Ch-Fsk/iot-home/下位机/硬件/器件清单.xlsx

器件 | 数量 | 单价 | 合计
1、0805电阻 | 9x2 | 0 | 0
2、0805电容 | 4x2 | 0 | 0
3、直插电容 | 1x2 | 0 | 0
4、蜂鸣器 | 1x2 | 0.8 | 1.6
5、OLED | 1x2 | 21.3 | 42.6
6、HDC1080 | 1x2 | 11.5 | 23
7、ESP-01 wifi | 1x2 | 7.95 | 16
8、Fan风扇 | 1x1 | 11.4+8（运费） | 19.4
9、TEMT6000光强 | 1x2 | 4 | 8
10、Mq2 | 1x1 | 4.6 | 4.6
10、Mq135 | 1X1 | 5.5 | 5.5
11、ss8050 | 2X4 | 0 | 0
12、铜柱 | 4X2X2 | 0.15 | 2.4
13、拨码开关 | 1X2 | 0.3 | 0.6
14、Stm32f103核心板 | 1X2 | 11 | 22
15、PCB打板 | 1X5 | 25+12（邮费） | 37
合计 | - | - | 182.7
