Ch-Fsk/iot-home/(list of files, drawings)

Other design files:
下位机/室内温度检测相关资料/室内空气净化监测原理图和PCB源文件/室内空气净化监测原理图和PCB源文件/430/室内空气监测MSP430.SchDoc
下位机/室内温度检测相关资料/室内空气净化监测原理图和PCB源文件/室内空气净化监测原理图和PCB源文件/STM32/室内空气监测STM32.SchDoc
下位机/硬件/室内环境检测系统/室内环境检测系统.PrjPcb
下位机/硬件/室内环境检测系统/室内环境检测系统.SchDoc
