Ch-Fsk/iot-home/下位机/程序/iotHome/User/hdc1080.c

#include "hdc1080.h"
#include "mi2c.h"
#include "delay.h"
#include "stdio.h"
#include "math.h"
#include "oled.h"
/*********************************************************************************
  * @ 函数名  ： HDC1080_Init
  * @ 功能说明： 初始化HDC1080
  * @ 参数    ： 无
  * @ 返回值  ： 无
  ********************************************************************************/
char hdc_buf[32];

void HDC1080_Init(void)
{
	uint8_t temp[2];
	unsigned int manufac_id,dev_id,Config_Reg ;
	
	IIC_Init();   //IIC初始化
	
	HDC1080_ReadReg(Manufacturer_ID,temp,2);
	manufac_id=(unsigned int)(temp[0]<<8);
	manufac_id+=temp[1];
	sprintf(hdc_buf,"MID = 0x%x\r\n",manufac_id);   /*打印制造商ID */
	OLED_ShowStr(0,0,hdc_buf,1);
	
	HDC1080_ReadReg(Device_ID,temp,2);
	dev_id=(unsigned int)(temp[0]<<8);
	dev_id+=temp[1];
	sprintf(hdc_buf,"Device_ID = 0x%x ",dev_id);   /*打印设备ID*/
	OLED_ShowStr(0,1,hdc_buf,1);
	if((manufac_id != Manufacturer_ID_value)||(dev_id != Device_ID_value))
	{
		sprintf(hdc_buf,"!!!ERROR,Please Check!!!");   /*打印设备连接成功*/
	}
	else 
	{
		sprintf(hdc_buf,"Online!!!");
	}
	OLED_ShowStr(0,2,hdc_buf,1);
	
	Config_Reg=Config_heateroff;   //关闭Heater,同时采集温度和湿度(温度在前),温度分辨率为14位,湿度分辨率为14位
	sprintf(hdc_buf,"config = 0x%x",Config_Reg);
	OLED_ShowStr(0,3,hdc_buf,1);
	HDC1080_WriteReg(Configuration,Config_Reg);  
	
	HDC1080_ReadReg(Configuration,temp,2);
	Config_Reg=(unsigned int)(temp[0]<<8);
	Config_Reg+=temp[1];
	if(Config_Reg == Config_heateroff)   /*检查是否写入成功*/
	{
			sprintf(hdc_buf,"Config success.");   
	}
	else 
	{
			sprintf(hdc_buf,"Configu reg failed.");   
	}
	OLED_ShowStr(0,4,hdc_buf,1);
	
}

/*********************************************************************************
  * @ 函数名  ： HDC1080_WriteReg
  * @ 功能说明： 写数据到寄存器内
  * @ 参数    ： 
	*              WriteAddr:内部寄存器地址
	*							 Data:将要写入的数据
  * @ 返回值  ： 无
  ********************************************************************************/
void HDC1080_WriteReg(u8 WriteAddr,unsigned int Data)
{
	unsigned char data[2];
	data[0] = (uint8_t)((Data& 0xFF00) >> 8);
	data[1] = (uint8_t)(Data & 0x00FF);
	IIC_Start();   //起始信号
	IIC_Send_Byte(HDC1080_I2C_ADDR);   //发送HDC1080设备地址+写信号
	IIC_Wait_Ack();
	IIC_Send_Byte(WriteAddr);   //内部寄存器地址
	IIC_Wait_Ack();
	IIC_Send_Byte(data[0]);   //写入内部寄存器数据
	IIC_Wait_Ack();
	IIC_Send_Byte(data[1]);   //写入内部寄存器数据
	IIC_Wait_Ack();
	IIC_Stop();   //停止信号
	
}

/*********************************************************************************
  * @ 函数名  ： HDC1080_ReadReg
  * @ 功能说明： 读取寄存器内的数据
  * @ 参数    ： 
	*              ReadAddr:内部寄存器地址
  *              pBuffer:数据数组首地址
	*              length:要读出数据的个数
  * @ 返回值  ： 无
  ********************************************************************************/
u8 HDC1080_ReadReg(u8 ReadAddr,u8 *pBuffer,u16 length)
{
		  	    																 
  IIC_Start();   //起始信号
	IIC_Send_Byte(HDC1080_I2C_ADDR);   //发送HDC1080设备地址+写信号
	IIC_Wait_Ack();  
	IIC_Send_Byte(ReadAddr);   //内部寄存器地址
	IIC_Wait_Ack();
	IIC_Start();   //起始信号
	IIC_Send_Byte(HDC1080_I2C_ADDR+1);   //发送HDC1080设备地址+读信号
	IIC_Wait_Ack(); 
	while(length)
	{
		*pBuffer++=IIC_Read_Byte(1);   //读出寄存器数据
		length--;
	}
	IIC_NAck();   //发送nACK
  IIC_Stop();   //停止信号	    
	return 0;
	
}

/*********************************************************************************
  * @ 函数名  ： Read_Temp_Humi_Reg
  * @ 功能说明： 读取温度和湿度寄存器数值
  * @ 参数    ： 
	*              data:温度和湿度寄存器数值
  * @ 返回值  ： 无
  ********************************************************************************/
void Read_Temp_Humi_Reg(u8 *data)
{
	data[0]=0;
	data[1]=0;
	data[2]=0;
	data[3]=0;
	IIC_Start();   //起始信号
	IIC_Send_Byte(HDC1080_I2C_ADDR);   //发送HDC1080设备地址+写信号
	IIC_Wait_Ack();  
	IIC_Send_Byte(Temperature);   //触发测量
	IIC_Wait_Ack();
	DelayMs(20);   /* Temp转换时间 + Humi转换时间 = 20ms */
	IIC_Start();   //起始信号
	IIC_Send_Byte(HDC1080_I2C_ADDR+1);   //发送HDC1080设备地址+读信号
	IIC_Wait_Ack(); 
	data[0]=IIC_Read_Byte(1);   /* 读取温度寄存器数值 */
	data[1]=IIC_Read_Byte(1);
	data[2]=IIC_Read_Byte(1);   /* 读取湿度寄存器数值 */
	data[3]=IIC_Read_Byte(1);
	IIC_Stop();   //停止信号  
	
}

/*********************************************************************************
  * @ 函数名  ： Convert_HDC1080_TempHumidity
  * @ 功能说明： 转化温度和湿度
  * @ 参数    ： 
	*              data:温度和湿度寄存器数值
  * @ 返回值  ： 无
  ********************************************************************************/
void Convert_HDC1080_TempHumidity(float *temp,float *humi)
{
		u8 data[4];
    /* 采集温湿度 */
    Read_Temp_Humi_Reg(data);      
    /* 温度转换 */
    *temp=(float)(data[0]<<8|data[1]);  
    *temp=(*temp/pow(2,16))*165-40;
    /* 湿度转换 */
    *humi=0;  
    *humi=(float)(data[2]<<8|data[3]);
    *humi=(*humi/pow(2,16))*100;
	
}
