Ch-Fsk/iot-home/下位机/程序/iotHome/User/usart.c

#include "sys.h"
#include "usart.h"	
#include "led.h"
#include "delay.h"
#include "alert.h"
#include <stdlib.h>

//////////////////////////////////////////////////////////////////
//加入以下代码,支持printf函数,而不需要选择use MicroLIB	  
#if 1
#pragma import(__use_no_semihosting)             
//标准库需要的支持函数                 
struct __FILE 
{ 
	int handle; 

}; 

FILE __stdout;       
//定义_sys_exit()以避免使用半主机模式    
_sys_exit(int x) 
{ 
	x = x; 
} 
//重定义fputc函数 
int fputc(int ch, FILE *f)
{      
	while((USART1->SR&0X40)==0);//循环发送,直到发送完毕   
    USART1->DR = (u8) ch;      
	return ch;
}
#endif 

/*使用microLib的方法*/
 /* 
int fputc(int ch, FILE *f)
{
	USART_SendData(USART1, (uint8_t) ch);

	while (USART_GetFlagStatus(USART1, USART_FLAG_TC) == RESET) {}	
   
    return ch;
}
int GetKey (void)  { 

    while (!(USART1->SR & USART_FLAG_RXNE));

    return ((int)(USART1->DR & 0x1FF));
}
*/
 

//串口1中断服务程序
//注意,读取USARTx->SR能避免莫名其妙的错误   	
u8 USART_RX_BUF[USART_REC_LEN];     //接收缓冲,最大USART_REC_LEN个字节.
u16 USART_RX_STA=0;       //接收状态标记	  
  
void USART1_Init(u32 baudRate){
  //GPIO端口设置
  GPIO_InitTypeDef GPIO_InitStructure;
	USART_InitTypeDef USART_InitStructure;
	NVIC_InitTypeDef NVIC_InitStructure;
		
	//使能USART1，GPIOA时钟	 
	RCC_APB2PeriphClockCmd(RCC_APB2Periph_USART1|RCC_APB2Periph_GPIOA, ENABLE);
  
	//USART1_TX   GPIOA.9
  GPIO_InitStructure.GPIO_Pin = GPIO_Pin_9; //PA.9
  GPIO_InitStructure.GPIO_Speed = GPIO_Speed_50MHz;
  GPIO_InitStructure.GPIO_Mode = GPIO_Mode_AF_PP;	//复用推挽输出
  GPIO_Init(GPIOA, &GPIO_InitStructure);//初始化GPIOA.9
   
  //USART1_RX	  GPIOA.10初始化
  GPIO_InitStructure.GPIO_Pin = GPIO_Pin_10;//PA10
  GPIO_InitStructure.GPIO_Mode = GPIO_Mode_IN_FLOATING;//浮空输入
  GPIO_Init(GPIOA, &GPIO_InitStructure);//初始化GPIOA.10  

  //Usart1 NVIC 配置
  NVIC_InitStructure.NVIC_IRQChannel = USART1_IRQn;
	NVIC_InitStructure.NVIC_IRQChannelPreemptionPriority=3 ;//抢占优先级3
	NVIC_InitStructure.NVIC_IRQChannelSubPriority = 3;		//子优先级3
	NVIC_InitStructure.NVIC_IRQChannelCmd = ENABLE;			//IRQ通道使能
	NVIC_Init(&NVIC_InitStructure);	//根据指定的参数初始化VIC寄存器
  
   //USART 初始化设置

	USART_InitStructure.USART_BaudRate = baudRate;//串口波特率
	USART_InitStructure.USART_WordLength = USART_WordLength_8b;//字长为8位数据格式
	USART_InitStructure.USART_StopBits = USART_StopBits_1;//一个停止位
	USART_InitStructure.USART_Parity = USART_Parity_No;//无奇偶校验位
	USART_InitStructure.USART_HardwareFlowControl = USART_HardwareFlowControl_None;//无硬件数据流控制
	USART_InitStructure.USART_Mode = USART_Mode_Rx | USART_Mode_Tx;	//收发模式

  USART_Init(USART1, &USART_InitStructure); //初始化串口1
  USART_ITConfig(USART1, USART_IT_RXNE, ENABLE);//开启串口接受中断
  USART_Cmd(USART1, ENABLE);                    //使能串口1 

}
 
/*
************************************************************
*	函数名称：	UsartPrintf
*
*	函数功能：	格式化打印
*
*	入口参数：	USARTx：串口组
*				fmt：不定长参
*
*	返回参数：	无
*
*	说明：		
************************************************************
*/
void USART_Printf(USART_TypeDef *USARTx, char *fmt,...)
{ 
	unsigned char UsartPrintfBuf[296];
	va_list ap;
	unsigned char *pStr = UsartPrintfBuf;
	
	va_start(ap, fmt);
	vsprintf((char *)UsartPrintfBuf, fmt, ap);				//格式化
	va_end(ap);
	
	while(*pStr != 0)
	{
		USART_SendData(USARTx, *pStr++);
		while(USART_GetFlagStatus(USARTx, USART_FLAG_TC) == RESET);
	}
}


/*
************************************************************
*	函数名称：	Usart_SendString
*
*	函数功能：	串口数据发送
*
*	入口参数：	USARTx：串口组
*				str：要发送的数据
*				len：数据长度
*
*	返回参数：	无
*
*	说明：		
************************************************************
*/
 
void USART_SendStr(USART_TypeDef *USARTx, char *str, u8 len)
{
 
	unsigned short count = 0;
	
	for(; count < len; count++)
	{
		USART_SendData(USARTx, *str++);						//发送数据
		while(USART_GetFlagStatus(USARTx, USART_FLAG_TC) == RESET);		//等待发送完成
	}
}


// 回传指令处理
// 帧头|功能|参数 
// *T2000#,T为阈值设置，2000为参数
// *SB1#开关状态，B为蜂鸣器、F为风扇，1为开、0为关

extern u16 Threshold_YW;
u8 App_Beep_Sw=OFF,App_Fan_Sw=OFF;
char buf2[8];
int th;

void USART1_IRQHandler(void)                	//串口1中断服务程序
{
	char data;
	static u8 i=0,start=0,fn=0,arg=0;

	if(USART_GetITStatus(USART1, USART_IT_RXNE) != RESET)  //接收中断
	{
		data = USART_ReceiveData(USART1);  					// 串口1 接收
		
		if(start == 0){
			if(data == '*') start = 1;			
			i = 0;
		}else {
			if(i<6) buf2[i] = data; else{ i=0; start=0;}
			if(data == '#'){
				switch(buf2[0]){
					case 'T' : 
						buf2[i]='\0'; th=atoi(buf2+1); if(th>0 && th<1000) Threshold_YW=th; 
					break;
					case 'S' : 					
							if(buf2[1] == 'B') App_Beep_Sw= buf2[2]-'0';
							if(buf2[1] == 'F') App_Fan_Sw = buf2[2]-'0';
					break;
				}
				start =0;
				i=0;
			}		
			i++;			
		}	
  }
} 
