Ch-Fsk/iot-home/下位机/程序/iotHome/User/adc.c

#include "adc.h"
#include "delay.h"

void ADC_GPIO_Init(void)
{
	GPIO_InitTypeDef t_gpio;
	RCC_APB2PeriphClockCmd(RCC_APB2Periph_GPIOA,ENABLE);//使能 GPIOA 时钟
	t_gpio.GPIO_Pin=GPIO_Pin_0|GPIO_Pin_1|GPIO_Pin_7;  //GPIOA.0.1.7
	t_gpio.GPIO_Mode=GPIO_Mode_AIN;//模拟输入模式
	GPIO_Init(GPIOA,&t_gpio);//初始化GPIOA
}
 
void ADC_Conf_Init(void)
{
	ADC_InitTypeDef t_adc;	
	
	ADC_GPIO_Init();
	
	RCC_APB2PeriphClockCmd(RCC_APB2Periph_ADC1,ENABLE);//使能ADC1时钟
	t_adc.ADC_Mode = ADC_Mode_Independent;  //独立模式：ADC1与ADC2独立
	t_adc.ADC_ScanConvMode = DISABLE; //禁用通道扫描
	t_adc.ADC_ContinuousConvMode = DISABLE; //禁用连续转换
	t_adc.ADC_ExternalTrigConv = ADC_ExternalTrigConv_None;//不使用外部触发
	t_adc.ADC_DataAlign = ADC_DataAlign_Right; //数据位右对齐
	t_adc.ADC_NbrOfChannel = 1; //转换通道数为1
	ADC_Init(ADC1,&t_adc); //初始化ADC1	
	RCC_ADCCLKConfig(RCC_PCLK2_Div8);//配置ADC时钟为PCLK2的8分频
	ADC_Cmd(ADC1,ENABLE); //使能ADC1
	ADC_ResetCalibration(ADC1); 
	while(ADC_GetResetCalibrationStatus(ADC1)); 
	ADC_StartCalibration(ADC1); //校准
	while(ADC_GetCalibrationStatus(ADC1)){};
}
 
u16 adc_read_value(u8 ch)
{
	u16 adc_value = 0;
	ADC_RegularChannelConfig(ADC1, ch, 1, ADC_SampleTime_7Cycles5 ); //设置ADC1通道ch的转换周期为7.5个采样周期，采样次序为1
	ADC_SoftwareStartConvCmd(ADC1, ENABLE);//使能软件触发
	while(!ADC_GetFlagStatus(ADC1, ADC_FLAG_EOC )){};//等待转换完成
	adc_value = ADC_GetConversionValue(ADC1); //获取转换值	
	return adc_value;
}

u16 ADC_Read_Stable(u8 ch)
{
	int i;
	u32 value=0;
	for(i=0;i<10;++i){
		value+=adc_read_value(ch);
		DelayUs(20);
	}
	return value/10;
}
