Ch-Fsk/iot-home/下位机/程序/iotHome/User/alert.h

#ifndef __ALERT_H
#define __ALERT_H

#include "sys.h"

//  开关
#define SW1 PBin(13) 
#define SW2 PBin(12)
#define ON  1
#define OFF 0

// 蜂鸣器、风扇
#define BEEP PBout(11)
#define FAN  PCout(14)

void Alert_Init(void);
void Beep_Set(u8 s);
void Fan_Set(u8 s);
u8 SW_Scan(u8 k);

#endif
