Ch-Fsk/iot-home/下位机/程序/iotHome/User/mi2c.h

#ifndef __MI2C_
#define __MI2C_

#include "sys.h"
 
//IO方向设置
//使用IIC1 挂载M24C02,OLED,LM75AD,HT1382    PB6,PB7  PA5:SDA\PA6:SCL 
#define SDA_IN()  {GPIOA->CRL&=0XFF0FFFFF;GPIOA->CRL|=(u32)8<<20;}
#define SDA_OUT() {GPIOA->CRL&=0XFF0FFFFF;GPIOA->CRL|=(u32)3<<20;}

//IO操作函数	 
#define IIC_SCL    PAout(6) //SCL
#define IIC_SDA    PAout(5) //SDA	 
#define READ_SDA   PAin(5)  //输入SDA 

//IIC所有操作函数
void IIC_Init(void);                //初始化IIC的IO口				 
void IIC_Start(void);				//发送IIC开始信号
void IIC_Stop(void);	  			//发送IIC停止信号
void IIC_Send_Byte(u8 txd);			//IIC发送一个字节
u8 IIC_Read_Byte(unsigned char ack);//IIC读取一个字节
u8 IIC_Wait_Ack(void); 				//IIC等待ACK信号
void IIC_Ack(void);					//IIC发送ACK信号
void IIC_NAck(void);				//IIC不发送ACK信号

void IIC_Write_One_Byte(u8 daddr,u8 addr,u8 data);
u8 IIC_Read_One_Byte(u8 daddr,u8 addr);	

#endif
