Ch-Fsk/iot-home/下位机/程序/iotHome/User/usart.h

#ifndef __USART_H
#define __USART_H

#include "stdio.h"	
#include "sys.h" 
#include "stdarg.h"
#include "stdlib.h"

#define USART_REC_LEN  			200  	//定义最大接收字节数 200
#define EN_USART1_RX 			  1		//使能（1）/禁止（0）串口1接收
	  	
extern u8  USART_RX_BUF[USART_REC_LEN]; //接收缓冲,最大USART_REC_LEN个字节.末字节为换行符 
extern u16 USART_RX_STA;         		//接收状态标记	

void USART1_Init(u32 baudRate);
void USART_SendStr(USART_TypeDef *USARTx, char *str, u8 len);
void USART_Printf(USART_TypeDef *USARTx, char *fmt,...);
void Bt_Upload_States(u8 state,u32 energy);

#endif
